bears-chj7/biocover/docs/dashboard.md

# 로컬 센서 웹 대시보드

Jetson 자체에서는 **http://127.0.0.1:8080**, 다른 기기에서는
**http://192.168.123.101:8080**으로 접속한다(2026-09-13 현재 LAN IP).
서버는 기본 0.0.0.0:8080에서 IPv4 접속을 받는다. 로그인은 없다. 외부 CDN 없이 로컬 CSS/JavaScript/Canvas를 사용한다.

## 통합 탭

8080 한 주소에서 **실시간 / 로그 재생**을 선택한다. 탭 전환만으로 측정이 중단되거나
재생 파일·위치·배속이 초기화되지 않는다. 별도 8081 서비스는 사용하지 않는다.
서비스 설치·시작·종료는 아래의 `biocover-web.service` 명령 하나로 관리한다.
[재생 기능 사용법](replay.md)

## 설치 및 실행

현재 환경에서 Flask 3.1.2 설치를 확인했다. 다른 환경의 의존성은
`web/requirements.txt`에 기록했다. 실행 중인 CH340 드라이버와 기존 UNO udev 규칙을 사용한다.

```bash
sudo python3 scripts/install_dashboard.py
```

설치기는 기존 `biocover-uno.service` 자동 CSV 수집을 중지/비활성화하고
`biocover-web.service`를 설치하되 중지/비활성화 상태로 둔다. 서비스는 judgejack 권한과 gpio 보조 그룹으로
실행한다. 부팅 및 서비스 오류 후 자동 실행하지 않으며 사용자가 직접 시작한다. **새 측정은 시작 버튼을 눌러야 한다. 재개 정보가 있는 진행 중 세션은 같은 CSV에 이어 쓴다.**
기존 웹 서비스 파일이 있으면 `/var/backups/biocover/UTC시각/`에 백업한다.
사용자가 관리자 비밀번호를 입력해야 하며 에이전트의 sudo -n 시도는 실패했다.
이 문서 작성 시점에서 시스템 설치/실제 센서 웹 수신 검증은 대기 상태다.

수동 실행은 기존 수집 서비스를 먼저 중지한 다음:

```bash
python3 web/app.py
```

기본 포트 8080, 데이터 폴더 data/web. `--port`와 `--data-dir`로 변경 가능하다.
동일 폴더로 두 서버를 실행하면 잠금으로 거부한다. 설치 서비스와 수동 서버를 동시에
실행하지 않는다. 앱은 가짜/예제 값을 센서값 대신 표시하지 않는다.

## 화면과 측정 동작

- 시작: 새 세션, 최신 UNO 캐시 + 그 시점의 ADC 읽기. 즉시 첫 행,
  이후 5초마다 갱신. 첫 UNO 응답 전에는 해당 항목을 결측으로 기록한다.
- 일시정지: CSV/로그/그래프 추가를 멈춘다. UNO 입력은 계속 받아 최신값을 유지한다.
- 재개: 같은 세션 파일에 최신값부터 이어 기록한다. 정지 구간을 소급해 채우지 않는다.
- 정지: 파일을 마무리하고 다운로드 목록에 표시한다. 다음 시작은 새 세션이다.
- 센서 8개 항목: DS18 온도, DHT22 온도/습도, MQ-4 #1~#4 raw, 토양수분 raw.
  ADC는 공칭 VREF 3.3V 전압도 표시한다. ppm/수분 % 보정은 하지 않는다.
- 미연결 CM1106은 별도 표시한다. MQ-4 #1은 유입, #2/#3/#4는 유출로 표시한다.
- 집계: 세션 전체의 유효값만으로 평균/최솟값/최댓값 계산. 결측은 제외한다.
- 그래프: 최근 5/10/30분, 1시간, 2시간, 전체 선택. 전체는 현재 측정 세션 시작부터 표시한다.
  최근 범위 선택 시 표시 범위 밖 값은 왼쪽으로 빠져나간다.
  결측과 일시정지 구간을 선으로 연결하지 않는다.
  토양 온도·공기 온도·습도·MQ-4 #1~#4·토양수분을 각각 분리하여
  한 행에 한 계열씩 총 8개 그래프로 표시한다. 모바일에서도 단일 열을 유지하고
  시간축 눈금 수를 줄여 겹침을 방지한다.
  표시 폭이 30분 이상이면 점을 숨기고 선만 표시하며, 미만이면 반지름 1.2px의 작은 점을 표시한다.
- 그래프 패널을 오른쪽으로 드래그하면 과거, 왼쪽으로 드래그하면 이후 구간을 본다.
  여덟 그래프의 시간축이 함께 이동한다. 과거 구간은 새 측정이 와도 고정하며
  **최신 구간** 버튼이나 오른쪽 끝까지 이동하면 다시 최신값을 따라간다.
  범위를 바꾸거나 새 세션을 시작해도 최신 구간으로 돌아간다.
  **← 이전 데이터 / 이후 데이터 →** 표시는 해당 측정값이 화면 밖에 남아 있는 방향에만 나타난다.
  전체 범위에서는 이미 모든 기록이 보여 이동하지 않는다. 측정·카드·통계·CSV는 그래프 이동의 영향을 받지 않는다.
  그래프에 키보드 포커스를 두고 좌우 방향키, Home/End로도 이동할 수 있다.
- 로그: 최신순 120행의 스크롤 영역. 서버 메모리는 최근 720행으로 제한하며
  화면에서 사라진 행도 CSV에는 남는다.
- 긴 범위에 필요한 과거 기록은 읽기 전용 `/api/history`로 현재 세션 CSV에서 가져온다.
  브라우저는 최근 값과 sequence로 합쳐 보관하므로 새로고침 후에도 시작 시점부터 조회할 수 있다.
  이 변경을 처음 반영할 때는 측정을 마친 후 웹서비스를 한 번 재시작해야 한다.
- 브라우저 새로고침은 서버 세션을 유지한다. 모든 브라우저는 같은 측정 세션을 본다.
  브라우저 연결이 끊기거나 모바일 화면이 잠겨도 측정을 계속한다.
  웹의 사용자 정지 시 세션을 마무리한다. 서비스 종료 시에는 다음 실행에서 이어 쓰도록 보존한다. 일시정지도 연결 여부와 무관하게 유지한다.

UNO는 약 2초 주기로 수신하고, 마지막 수신이 6초보다 오래되면 이전 값을 재사용하지 않는다.
USB 연결 오류나 ADC 오류는 해당 그룹의 결측으로 기록한다. 정상 형식의 숫자가
센서 교정 정확도를 보장하지는 않는다. 웹 화면은 2초마다 상태를 조회하지만
측정/CSV/로그의 새 행은 5초마다 하나다.

## CSV와 비정상 종료

진행 중: `data/web/session-YYYYMMDDTHHMMSS.ffffffZ.partial.csv`.
웹에서 정상 정지: 같은 타임스탬프의 `.csv`. `data/web/session-state.json`에는
진행 중 CSV와 시작 시각·행 수·측정 상태·교반 설정을 저장한다. 서비스 재시작 시
마지막 불완전 행을 제거하고 같은 `.partial.csv`에 이어 쓴다. 일시정지 상태는 유지한다.
자동 교반 판단용 최근값도 CSV에서 복원하며, 유효한 최근 기록이 충분하면 새 기준 수집을 기다리지 않는다.
교반 후 남은 재구동 대기 시간은 유지한다. 상세 조건은 [자동 교반 사용법](auto-mixer.md)을 참고한다.
재개 정보가 없는 과거 부분 파일만 `-recovered.csv`로 보존한다.
파일명/CSV 시각은 UTC이며 화면 시각은 브라우저 시간대다.

각 측정 행마다 flush + fsync하고, 파일 이름 변경 후 디렉터리도 fsync한다.
SIGTERM/일반 종료와 SIGKILL 모두 다음 실행에서 진행 중 세션을 복원하며
마지막 완료된 기록까지 유지한다. 전원 차단 중 진행하던 행과 저장장치 자체의
장애까지 보장할 수는 없다. 저장 오류 시 측정 상태를 오류로 전환한다.
파일 보존 기간/자동 삭제는 설정하지 않았으므로 디스크 사용량을 관리한다.

CSV 열: timestamp, sequence, elapsed_s, ds18, temperature, humidity,
mq1, mq2, soil, mq1_v, mq2_v, soil_v, uno_received_at, uno_time_ms,
uno_age_s, uno_status, adc_status, errors.
elapsed_s는 일시정지를 포함한 세션 경과 시간이다. UNO time_ms는 별도 기기의 uptime이다.
기존 data/arduino 파일은 보존하지만 대시보드 세션 목록은 data/web만 표시한다.

## 검증

```bash
python3 -m unittest discover -s tests -p test_dashboard.py -v
node --check web/static/app.js
```

자동 검증: 시작 전 미저장, 중복 시작 거부, 일시정지/재개/정지, CSV 행과 통계,
파일 다운로드, 다른 출처의 제어 요청 차단, 브라우저 단절 후 측정 유지, UNO 데이터 신선도,
실제 자식 프로세스 SIGKILL 후 CSV 복구. 센서값은 테스트에서만 합성 입력을 사용한다.

6개 unittest와 Python/JavaScript/systemd 문법 검증을 통과했다.
현재 로컬 Chromium의 Snap/GLIBC/ICU 실행 오류로 브라우저 화면 캡처는 완료하지 못했다.
설치 후 실제 화면과 실측 수신의 최종 확인이 필요하다.

## 서비스 관리

설치는 한 번만 수행한다. 이미 자동 실행으로 설치했으면 아래 명령을 한 번 실행한다.

```bash
sudo systemctl disable --now biocover-web.service
```

필요할 때 시작하고 브라우저에서 http://127.0.0.1:8080 을 연다.

```bash
sudo systemctl start biocover-web.service
```

사용을 마치면 화면의 정지 버튼으로 측정을 종료한 뒤 웹서버도 중지할 수 있다.
서비스 중지만 하면 다음 서비스 실행에서 진행 중 CSV에 이어 쓴다.

```bash
sudo systemctl stop biocover-web.service
```

```bash
systemctl status biocover-web.service --no-pager
journalctl -u biocover-web.service -n 30 --no-pager
sudo systemctl disable --now biocover-web.service
```

웹서버를 중지해도 기존 CSV를 삭제하지 않는다. 독립 센서 스크립트 실행 전
웹 측정 세션을 정지해서 USB 포트를 반환한다.
구현 참고: [Flask 공식 문서](https://flask.palletsprojects.com/en/stable/quickstart/).

## 다른 기기에서 IP로 접속

현재 Wi-Fi 주소는 `192.168.123.101/24`이며 DHCP에 따라 바뀔 수 있다.
주소 확인은 `ip -br address`. `0.0.0.0`은 서버가 듣는 주소이며 브라우저에 입력할 주소가 아니다.
로컬 접속만 원하면 수동 실행 시 `python3 web/app.py --host 127.0.0.1` 사용.
IP 주소 요청은 허용하고, 다른 웹사이트가 보내는 제어 요청은 계속 거부한다.
로그인이 없으므로 접속 가능한 기기는 같은 측정 세션을 제어하고 CSV를 내려받을 수 있다.

이전 실행 프로세스는 재시작해야 수정이 반영된다. 아래 명령은 서버 재시작 후
리스닝 주소, 자기 IP HTTP 응답, UFW 및 INPUT 규칙을 조회한다. 방화벽은 변경하지 않는다.
진행 중인 측정은 재시작 후 같은 CSV에 이어 쓴다. 중단 시간의 측정값은 채워 넣지 않는다.

```bash
sudo python3 scripts/check_web_network.py
```

자기 IP 요청 성공은 다른 기기에서의 접속 성공을 증명하지 않는다.
같은 네트워크의 기기에서 직접 접속해 확인한다. 공유기 밖 인터넷에서의 접속은
별도 라우팅/포트 전달이 필요하며 이 작업에서는 공유기 설정을 변경하지 않았다.
방화벽 조회는 에이전트의 sudo 비밀번호 요구로 아직 미완료다.

## MQ-4 네 개 수집과 이전 CSV

2026-10-09부터 CH0~CH3를 MQ-4 #1~#4로 읽고, CH4는 토양수분으로 유지한다.
5초마다 `mq1`~`mq4` raw와 `mq1_v`~`mq4_v` 전압을 함께 기록한다.
카드·평균/최솟값/최댓값·그래프·로그에 네 센서를 표시한다.

이전 2채널 CSV에는 `mq3`, `mq4`, `mq3_v`, `mq4_v`를 **0**으로 추가한다.
`mq34_backfilled=1`은 당시 측정하지 않은 값을 0으로 채웠다는 뜻이다.
새로운 측정 행은 `mq34_backfilled=0`이며, 통신 실패는 기존대로 빈 값으로 저장한다.
이전 기록의 0도 재생 통계에 포함되므로 새 센서 성능 분석 시 이 표시가 1인 행은 제외한다.

변환 스크립트는 완료된 `session-*.csv`만 처리하고 `.partial.csv`는 건너뛴다.
원본과 SHA-256 기록은 `data/backups/mq4-zero-fill-<UTC>/`에 보관한다.
기존 열의 값·시간·행 수·파일명·수정 시각을 보존하고, 새 파일로 원자적 교체하므로
파일시스템 생성 시각은 변환 시각이 될 수 있다. 이미 네 채널 열이 있으면 재변환하지 않는다.

```bash
cd /home/judgejack/working_space/biocover
python3 scripts/upgrade_mq4_csv.py          # 변경 대상 미리 보기
python3 scripts/upgrade_mq4_csv.py --apply  # 원본 백업 후 변환
sudo systemctl restart biocover-web.service
```

진행 중인 세션은 먼저 웹의 정지 버튼으로 정상 저장한다. 재시작 후 페이지를 새로고침하고
시작 버튼을 누르면 네 채널로 기록한다. [실제 전환 기록](../history/2026-10-09/four-mq4-dashboard.md)

## 모터 제어

실시간 탭의 모터 패널에서 USB 연결, 설정 각도 조회, 0~180도 전송을 지원한다.
측정을 시작하지 않고도 제어할 수 있다. [사용법과 저장 형식](motor-control.md)

자동 교반 패널은 유출 #2/#3/#4 각각의 기준 대비 변화율 차이 또는 공통 상승을 감지한다.
기본은 꺼짐이며 [자동 교반 사용법](auto-mixer.md)에 따라 측정 중 활성화한다.
