bears-chj7/biocover/history/README.md

# 실험·장치 작업 이력

현재 상태와 계획은 [프로젝트 README](../README.md), 날짜별 작업 경위와 증거는 이 디렉터리에서 관리합니다.
시간은 별도 표기 없으면 KST(UTC+09:00)입니다. 커널 부팅 로그의 시계 동기화 전 날짜는 실제 작업 시각으로 사용하지 않습니다.

| 날짜 | 이력 | 최종 확인 상태 |
|---|---|---|
| 2026-10-10 | [자동 교반 후속 확인](2026-10-09/auto-mixer.md#2026-10-10-사용자-확인) | 사용자가 확인 완료를 전달함 |
| 2026-10-09 | [MQ-4 점검](2026-10-09/mq4-four-channel-check.md) · [4채널 수집·CSV 전환](2026-10-09/four-mq4-dashboard.md) · [UNO 모터 제어](2026-10-09/arduino-motor.md) · [자동 교반](2026-10-09/auto-mixer.md) | 네 채널·유출 #3/#4·모터 응답 지원, CSV 총 4개 2,266행의 #3/#4 0 채움 |
| 2026-09-29 | [CSV 로그 재생 서버](2026-09-29/README.md) | 8081 별도 서비스 실행, 1~50배속·모바일 검증, 기존 8080 서비스 PID 유지 |
| 2026-09-14 | [브라우저 연결 만료 정지 수정](2026-09-14/README.md) | 117행 CSV 보존 확인, 45초 자동 정지 제거, 서비스 재시작 대기 |
| 2026-09-13 | [통합 타임라인](2026-09-13/README.md) · [USB 전환 이후](2026-09-13/usb-and-current-status.md) | UNO 온·습도와 ADC 3채널 수신 성공, 재부팅 후 CSV 재개 확인, 자동 저장 중지 적용 대기 |

## 기록 원칙

- 사용자 진술, 다른 세션 인계, 로컬 파일 확인, 실제 측정 결과를 구분합니다.
- 과거 ‘미설치’ 기록을 삭제해 성공으로 바꾸지 않고 이후 설치 증거를 연결합니다.
- ‘빌드 성공’, ‘설치 완료’, ‘드라이버 로드’, ‘센서 응답’, ‘보정 정확도’를 별도 상태로 기록합니다.
- 시스템 변경에는 대상 파일·백업·검증·미해결 사항을 남깁니다.
- 아카이브 파일은 당시 상태의 사본입니다. 이전 설치 스크립트·복원 안내를 현재 시스템에 그대로 실행하지 않습니다.
- 원시 측정값은 사용자가 명시적으로 요청할 때만 파일로 저장합니다. 이 디렉터리는 장치 구축 이력이며 원시 CSV는 Git에서 제외합니다.
