bears-chj7/biocover/history/2026-09-13/README.md

# 2026-09-13 통합 작업 이력

대상: 바이오커버 메탄 산화 측정 실험 / Jetson Orin Nano Super / L4T 36.4.7 / Linux 5.15.148-tegra.

## 세션 구분

**최신 상태:** [GPIO 반복 진단 → USB 전환 → 재부팅 검증 → 저장 정책 변경](usb-and-current-status.md).
아래 초기 타임라인과 문서의 미해결 표기는 당시 상태이며 최신 결과는 위 문서를 우선한다.

- **센서·저장소 세션:** SPI/ADC, DHT22, Git 저장소와 실험 개요를 관리한 현재 세션.
- **DS18B20 세션:** `/home/judgejack/project/ds18b20`에서 외부 모듈과 통합 오버레이를 준비한 다른 로컬 Codex 세션.
- **사용자:** 관리자 권한이 필요한 명령과 재부팅을 직접 수행.

다른 세션 인계의 ‘설치·로드 미검증’은 준비 작업 종료 시점의 상태입니다. 이후 사용자 설치·재부팅과 현재 세션의 확인 결과가 이를 갱신합니다. 두 기록은 모순이 아닙니다.

## 타임라인

정확한 명령 실행 시각이 남지 않은 단계는 대화 순서로만 표시합니다. 파일명·mtime는 보조 증거이며 모든 단계의 정확한 실행 시각을 보장하지 않습니다.

| 순서 / 확인 가능한 시각 | 담당 | 작업과 확인 |
|---|---|---|
| 초기 점검 | 센서 세션 | 인계문 ‘부팅 불가’와 달리 실제 OS 동작 확인. 샌드박스 제한을 구분한 후 SPI·UART·GPIO 장치 존재 확인 |
| 초기 연결 정정 | 사용자 | 최종 연결 상태: MQ-4 #1·#2, 토양수분, DHT22, DS18B20 연결. MQ-4 #3·#4, CM1106 미연결 |
| SPI 수정 전 | 센서 세션·사용자 | CH0~CH4 전부 0. Jetson-IO 조회에서 P19·21·23·24 unused |
| 16:51대 설정 파일 생성 / 재부팅 | 사용자 | Jetson-IO spi1 설정. 이후 활성 DT에서 SPI 기능 확인 |
| 16:55 전후 재검사 | 센서 세션 | CH0 181~186, CH1 115~121, CH4 820~834. DHT22 에지 0. CONFIG_W1 비활성 확인 |
| DHT22 핀 조회·수정 준비 | 사용자·센서 세션 | P15 tristate=1/input=1 확인. SPI를 보존하고 P15만 수정한 오버레이 컴파일·시험 병합 |
| DHT22 백업·설치 | 사용자 | 원본 before-dht22 백업. 후보와 설치본 SHA256 일치 확인. 다른 세션 작업 때문에 재부팅 보류 |
| 저장소 생성·정리 | 센서 세션 | GitHub 빈 저장소 clone, 실험 개요·배선·진단·설정 기록 작성 |
| 17:12:45 커밋 시각 | 센서 세션 | 초기 커밋 `4abdffd`. HTTPS 인증 실패 후 SSH 원격으로 전환해 main push 성공 |
| 다른 세션 준비 (파일 17:14~17:17대) | DS18B20 세션 | v5.15.148 W1 소스 외부 모듈 빌드, P7 통합 오버레이, 설치·읽기 스크립트·차이 검증 작성. 해당 세션은 sudo 암호 요구로 설치하지 않음 |
| 백업명 17:17:55 / 이후 재부팅 | 사용자 | 드라이버 설치·재부팅 완료 보고. 부팅 백업·설치본·현재 OVERLAYS로 후속 확인 |
| 17:23 이후 | 센서 세션 | SPI·P15 유지 확인. wire·w1_gpio 로드, w1_therm 파일 설치 확인. 정상 DS18B20 ID 없음 |
| 재부팅 후 ADC·DHT 검사 | 센서 세션 | CH0 168~173, CH1 109~114, CH4 804~809. DHT22 부분 펄스만 검출, 유효 프레임 없음 |
| 17:28:11 커밋 시각 | 센서 세션 | 재점검과 실험적 C 진단을 `82587f3`에 기록 |
| 17:35 전후 재점검 | 센서 세션 | CH0 207~214, CH1 149~155, CH4 803~809. DHT22 부분 펄스, DS18B20 정상 ID 없음; 설정 변경 없음 |
| 통합 history 작성 | 센서 세션 | 다른 세션 제공 인계·실제 파일·설치 증거·후속 실패를 날짜별 기록으로 통합 |

## 상세 문서

- [웹 대시보드 구현·검증 및 설치 대기](web-dashboard.md)

- [USB 전환과 재부팅 이후 최신 값·남은 작업](usb-and-current-status.md)
- [P7/P15 OS 감사와 TXB0108 원인 분석](gpio-os-audit.md)

- [센서·SPI·DHT22 작업](sensor-session.md)
- [DS18B20 빌드·설치·후속 검증](ds18b20-session.md)
- [현재 상태와 다음 작업](status-and-next.md)
- [증거 파일 설명](artifacts/README.md)
- [기존 상세 측정 로그](../../docs/2026-09-13-check.md)

## 주요 커밋

- `4abdffd`: 실험 개요와 센서 점검 및 Jetson 설정 기록 추가.
- `82587f3`: 드라이버 설치 후 센서 재점검과 DHT22 수신 한계 기록.
- 이 history를 추가한 커밋은 `git log -- history`에서 확인합니다.
