bears-chj7/biocover/history/2026-09-13/status-and-next.md

# 당일 최종 상태와 다음 작업

## 측정 가능 여부

| 대상 | 최종 상태 | 남은 일 |
|---|---|---|
| MQ-4 #1·#2 | ADC 값 읽힘 | 전압 범위·분압 확인, 예열·개별 보정, 농도·정확도 검증 |
| 토양수분 | CH4 값 읽힘 | 배지별 수분 보정·단위 정의 |
| DHT22 | P15 수정 적용, 부분 펄스 검출 | GPIO 읽기 타이밍/신호 검사, 완전 프레임·체크섬 확보 |
| DS18B20 | 외부 모듈 설치, 버스 생성 | 풀업 연결 보고 후 장치 0개. DATA 전압·배선·신호 검사, 28-… ID·CRC·온도 확보 |
| MQ-4 #3·#4 / CM1106 | 미연결 | 필요 시 추가 연결·배치·보정 |

## 다음 순서

1. P7 pinconf 조회는 완료됐습니다. 원문은 [증거 파일](artifacts/pin7-pinconf-user.txt)에 보관했습니다. 다음은 당시 사용한 조회 명령입니다.

```bash
sudo grep -i -A 14 'soc_gpio59_pac6' /sys/kernel/debug/pinctrl/2430000.pinmux/pinconf-groups
```

2. P7 설정 반영을 확인했으므로 DS18B20 전원·공통 GND·실제 4.7kΩ 풀업과 DATA 신호를 확인하며 드라이버 타이밍 가능성도 남겨 둡니다. 설정 변경은 기존 통합 SPI/P15/P7 내용을 보존합니다.
3. DHT22의 누락 없는 읽기 방식을 검증합니다. 현재 C 후보는 성공한 구현이 아닙니다.
4. 센서 검증 후 실험용 5초 CSV 수집, 보정, 유량·희석·실험 대조 설계를 구현합니다.

## 하지 않은 작업

이력 정리 과정에서 모듈 재설치·부팅 설정 변경·재부팅·가스 공급·파일시스템 복구는 하지 않았습니다. 센서가 정상 동작한다고 가정한 가짜 온도·농도 데이터도 생성하지 않았습니다.

## 동시 세션 작업

DS18B20 원래 준비 파일은 `/home/judgejack/project/ds18b20`에 유지합니다. 이력 사본은 원본 작업 디렉터리를 대체하지 않습니다. 같은 부팅 설정을 수정하는 경우 다른 세션의 최신 변경과 비교한 뒤 진행해야 합니다.

최신 사용자 보고: DS18 풀업 연결 완료, DHT22 실제 전원 P1 공유·3.4V 실측. DHT22 점검은 보류하고 DS18을 먼저 진행합니다. 18:33 전후 재검사에서 DS18은 장치 0개였습니다.
# 최신 상태 안내

이 문서의 초기 GPIO 진단 상태 이후 UNO USB 수신, 영구 설치 및 재부팅 후
수집 재개를 확인했다. [현재 상태와 저장 정책](usb-and-current-status.md)을 우선한다.
