bears-chj7/biocover/web/sensors.py

"""Live USB cache + on-demand ADC. No sensor data files are written here."""
import fcntl
import os
from pathlib import Path
import select
import subprocess
import sys
import termios
import threading
import time

sys.path.insert(0, str(Path(__file__).resolve().parents[1] / 'scripts'))
from read_arduino_usb import parse_line
from arduino_protocol import parse_event
from show_all_sensors import read_adc
from motor import Motor


class Sensors:
    def __init__(self, port='/dev/biocover-uno'):
        self.port = port
        self.lock = threading.Lock()
        self.stop_event = threading.Event()
        self.thread = None
        self.latest = None
        self.error = 'UNO 응답 대기'
        self.lifecycle = threading.Lock()
        self.motor = Motor()

    def start(self):
        with self.lifecycle:
            self._start()

    def _start(self):
        if self.thread and self.thread.is_alive():
            return
        result = subprocess.run(['systemctl', 'is-active', 'biocover-uno.service'],
                                capture_output=True, text=True, timeout=3)
        if result.stdout.strip() in ('active', 'activating'):
            raise RuntimeError('기존 CSV 수집 서비스가 실행 중입니다. 웹서버 설치 명령으로 전환해 주세요.')
        self.latest = None
        self.error = 'UNO 응답 대기'
        self.stop_event.clear()
        self.thread = threading.Thread(target=self._loop, daemon=True)
        self.thread.start()

    def _loop(self):
        while not self.stop_event.is_set():
            try:
                self._read_connection()
            except (OSError, ValueError) as exc:
                with self.lock:
                    self.error = f'UNO 연결 오류: {exc}'
                self.motor.offline(str(exc))
            self.stop_event.wait(2)

    def _read_connection(self):
        fd = os.open(self.port, os.O_RDWR | os.O_NOCTTY | os.O_NONBLOCK)
        old = None
        exclusive = False
        try:
            fcntl.flock(fd, fcntl.LOCK_EX | fcntl.LOCK_NB)
            fcntl.ioctl(fd, termios.TIOCEXCL)
            exclusive = True
            old = termios.tcgetattr(fd)
            attrs = termios.tcgetattr(fd)
            attrs[0] = attrs[1] = attrs[3] = 0
            attrs[2] = termios.CS8 | termios.CREAD | termios.CLOCAL
            attrs[4] = attrs[5] = termios.B9600
            attrs[6][termios.VMIN] = attrs[6][termios.VTIME] = 0
            termios.tcsetattr(fd, termios.TCSANOW, attrs)
            termios.tcflush(fd, termios.TCIFLUSH)
            self.motor.online()
            buffer = b''
            last = time.monotonic()
            while not self.stop_event.is_set():
                if time.monotonic() - last > 12:
                    raise OSError('12초 동안 새 데이터가 없습니다')
                payload = self.motor.outgoing()
                if payload:
                    # At most one command, never replayed after a reconnect.
                    deadline = time.monotonic() + 1
                    while payload:
                        if time.monotonic() >= deadline:
                            raise OSError('시리얼 명령 전송 시간 초과')
                        if not select.select([], [fd], [], .1)[1]:
                            continue
                        try:
                            sent = os.write(fd, payload)
                        except BlockingIOError:
                            continue
                        if not sent:
                            raise OSError('시리얼 명령 전송 실패')
                        payload = payload[sent:]
                if not select.select([fd], [], [], .25)[0]:
                    continue
                chunk = os.read(fd, 4096)
                if not chunk:
                    raise OSError('USB 연결 해제')
                buffer += chunk
                while b'\n' in buffer:
                    line, buffer = buffer.split(b'\n', 1)
                    if not line.strip():
                        continue
                    try:
                        text = line.decode('ascii').strip()
                        event = parse_event(text)
                        if event is not None:
                            self.motor.feed(event)
                            if event['kind'] == 'ready':
                                with self.lock:
                                    self.latest = None
                                    self.error = 'UNO 재시작 후 새 측정 대기'
                            continue
                        value = parse_line(text)
                    except (ValueError, UnicodeError):
                        continue
                    if value is not None:
                        self.motor.sensor_seen()
                        last = time.monotonic()
                        with self.lock:
                            self.latest = (value, last)
                            self.error = ''
                if len(buffer) > 4096:
                    buffer = b''
        finally:
            self.motor.offline()
            try:
                if old is not None:
                    termios.tcsetattr(fd, termios.TCSANOW, old)
            except OSError:
                pass
            try:
                if exclusive:
                    fcntl.ioctl(fd, termios.TIOCNXCL)
            except OSError:
                pass
            os.close(fd)

    def sample(self):
        with self.lock:
            cached, error = self.latest, self.error
        result = dict(ds18=None, temperature=None, humidity=None, mq1=None, mq2=None,
                      mq3=None, mq4=None, soil=None, mq1_v=None, mq2_v=None,
                      mq3_v=None, mq4_v=None, soil_v=None, mq34_backfilled=False,
                      uno_received_at=None, uno_time_ms=None, uno_age_s=None,
                      uno_status='waiting', adc_status='ok', errors=[])
        motor = self.motor.snapshot()
        result.update(motor_angle=motor['angle'], motor_reported_at=motor['reported_at'],
                      motor_status='disconnected' if not motor['connected'] else
                      'pending' if motor['pending'] else 'error' if motor['error'] else
                      'known' if motor['angle'] is not None else 'unset' if motor['reported_at'] else 'unknown')
        if cached:
            row, received = cached
            age = max(0, time.monotonic() - received)
            result.update(uno_received_at=row['received_at_utc'], uno_time_ms=row['time_ms'],
                          uno_age_s=round(age, 3))
            if age <= 6 and not error:
                result.update(ds18=row['DS18B20_C'], temperature=row['DHT22_C'], humidity=row['humidity_pct'],
                              uno_status='partial' if row['invalid_fields'] else 'ok')
                if row['invalid_fields']:
                    result['errors'].append('UNO 결측: ' + row['invalid_fields'])
            else:
                result['uno_status'] = 'stale'
                result['errors'].append(error or 'UNO 데이터가 6초 이상 오래됨')
        else:
            result['errors'].append(error or 'UNO 응답 대기')
        try:
            adc = read_adc()
            for key, name in [('mq1','MQ4_1'), ('mq2','MQ4_2'), ('mq3','MQ4_3'),
                              ('mq4','MQ4_4'), ('soil','soil_moisture')]:
                result[key] = adc[name]['raw']
                result[key + '_v'] = adc[name]['voltage_V_nominal']
        except (OSError, ValueError) as exc:
            result['adc_status'] = 'error'
            result['errors'].append(f'ADC 읽기 실패: {exc}')
        return result

    def close(self):
        with self.lifecycle:
            self._close()

    def _close(self):
        self.stop_event.set()
        if self.thread:
            self.thread.join(timeout=3)
            if self.thread.is_alive():
                raise RuntimeError('UNO 읽기 스레드 종료 대기 시간 초과')
            self.thread = None
        self.motor.offline()
