bears-chj7/biocover/web/app.py

#!/usr/bin/env python3
"""IP-accessible sensor dashboard. No recording until a browser presses Start."""
import argparse
import fcntl
import ipaddress
from pathlib import Path
import signal
import sys
from urllib.parse import urlparse

from flask import Flask, jsonify, render_template, request, send_file
from werkzeug.serving import make_server
from werkzeug.middleware.dispatcher import DispatcherMiddleware
from engine import Engine
from sensors import Sensors

ROOT = Path(__file__).resolve().parents[1]
if str(ROOT) not in sys.path:
    sys.path.insert(0, str(ROOT))
from replay.app import create_app as create_replay_app


def create_app(engine):
    app = Flask(__name__)
    app.config['MAX_CONTENT_LENGTH'] = 1024

    @app.before_request
    def check_request():
        hostname = urlparse(request.host_url).hostname
        if hostname != 'localhost':
            try:
                ipaddress.ip_address(hostname)
            except ValueError:
                return jsonify(error='Jetson의 IP 주소로 접속해 주세요.'), 403
        if request.method == 'POST':
            if not request.is_json:
                return jsonify(error='JSON 요청이 필요합니다.'), 415
            origin = request.headers.get('Origin')
            if origin and urlparse(origin).netloc != request.host:
                return jsonify(error='다른 사이트의 제어 요청은 허용하지 않습니다.'), 403

    @app.after_request
    def headers(response):
        response.headers['Cache-Control'] = 'no-store'
        response.headers['X-Content-Type-Options'] = 'nosniff'
        return response

    @app.get('/')
    def index():
        return render_template('shell.html')

    @app.get('/live')
    def live():
        return render_template('index.html')

    @app.get('/api/state')
    def state():
        return jsonify(engine.snapshot())

    def motor_controller():
        motor = getattr(engine.source, 'motor', None)
        if motor is None:
            raise RuntimeError('이 센서 소스는 모터 제어를 지원하지 않습니다.')
        return motor

    @app.get('/api/motor')
    def motor_state():
        try:
            return jsonify(motor_controller().snapshot())
        except RuntimeError as exc:
            return jsonify(error=str(exc)), 409

    @app.post('/api/motor/connect')
    def motor_connect():
        try:
            motor = motor_controller()
            engine.source.start()  # Opens USB only; does not start CSV recording.
            return jsonify(motor.snapshot())
        except (RuntimeError, OSError) as exc:
            return jsonify(error=str(exc)), 409

    @app.post('/api/motor/status')
    def motor_query():
        try:
            return jsonify(motor_controller().request())
        except (RuntimeError, OSError) as exc:
            return jsonify(error=str(exc)), 409

    @app.post('/api/motor')
    def motor_command():
        body = request.get_json(silent=True)
        if not isinstance(body, dict) or type(body.get('angle')) is not int or not 0 <= body['angle'] <= 180:
            return jsonify(error='angle은 0~180 사이의 정수여야 합니다.'), 400
        try:
            engine.mixer_resume_pending = False
            engine.mixer.disable('수동 각도 명령으로 자동 교반을 중단했습니다.')
            engine.checkpoint()
            return jsonify(motor_controller().request(body['angle']))
        except (ValueError, RuntimeError, OSError) as exc:
            return jsonify(error=str(exc)), 409

    @app.get('/api/mixer')
    def mixer_state():
        return jsonify(engine.mixer.snapshot())

    @app.post('/api/mixer/<action>')
    def mixer_control(action):
        body = request.get_json(silent=True)
        if not isinstance(body, dict):
            return jsonify(error='JSON 객체가 필요합니다.'), 400
        try:
            # Serialize enabling against measurement pause/stop.
            with engine.lock:
                if action == 'enable':
                    if engine.state != 'running':
                        raise ValueError('센서 측정을 시작한 뒤 자동 교반을 켜세요.')
                    result = engine.mixer.enable(history=engine.rows)
                    engine.mixer_resume_pending = False
                elif action == 'disable':
                    engine.mixer_resume_pending = False
                    engine.mixer.disable()
                    result = engine.mixer.snapshot()
                elif action == 'settings':
                    result = engine.mixer.configure(body)
                else:
                    return jsonify(error='알 수 없는 자동 교반 동작'), 404
                engine.checkpoint()
            return jsonify(result)
        except (ValueError, RuntimeError) as exc:
            return jsonify(error=str(exc)), 409

    @app.get('/api/history')
    def history():
        try:
            after = int(request.args.get('after', '0'))
            limit = int(request.args.get('limit', '5000'))
            if after < 0 or not 1 <= limit <= 10000:
                raise ValueError()
        except ValueError:
            return jsonify(error='after는 0 이상, limit는 1~10000 정수여야 합니다.'), 400
        try:
            return jsonify(engine.history(after, limit))
        except OSError:
            return jsonify(error='세션 CSV를 읽을 수 없습니다.'), 503

    @app.post('/api/<action>')
    def control(action):
        if action not in ('start', 'pause', 'resume', 'stop', 'heartbeat'):
            return jsonify(error='알 수 없는 동작'), 404
        try:
            getattr(engine, action)()
            return jsonify(engine.snapshot())
        except (ValueError, RuntimeError, OSError) as exc:
            return jsonify(error=str(exc)), 409

    @app.get('/api/files')
    def files():
        return jsonify(engine.files())

    @app.get('/download/<name>')
    def download(name):
        if Path(name).name != name or name not in {v['name'] for v in engine.files()}:
            return jsonify(error='저장된 CSV를 찾을 수 없습니다.'), 404
        return send_file(engine.directory / name, as_attachment=True, download_name=name)

    # Keep upload limits, request guards and APIs separate while sharing one
    # HTTP listener. Replay never receives the engine or sensor object.
    replay = create_replay_app(engine.directory, integrated=True)
    app.wsgi_app = DispatcherMiddleware(app.wsgi_app, {'/replay': replay})
    return app


def main():
    parser = argparse.ArgumentParser(description=__doc__)
    parser.add_argument('--port', type=int, default=8080)
    parser.add_argument('--host', default='0.0.0.0', help='IPv4 listen address; default all interfaces')
    parser.add_argument('--data-dir', type=Path, default=Path(__file__).resolve().parents[1] / 'data/web')
    args = parser.parse_args()
    args.data_dir.mkdir(parents=True, exist_ok=True)
    lock = (args.data_dir / '.dashboard.lock').open('a')
    try:
        fcntl.flock(lock, fcntl.LOCK_EX | fcntl.LOCK_NB)
    except BlockingIOError:
        raise SystemExit('이미 이 데이터 폴더의 대시보드가 실행 중입니다.')
    engine = Engine(Sensors(), args.data_dir)
    server = make_server(args.host, args.port, create_app(engine), threaded=True)
    def terminate(signum, frame):
        raise KeyboardInterrupt
    signal.signal(signal.SIGTERM, terminate)
    print(f'Biocover listening: {args.host}:{args.port} (접속: http://<Jetson-IP>:{args.port}; 측정 상태: {engine.state})', flush=True)
    try:
        server.serve_forever()
    except KeyboardInterrupt:
        pass
    finally:
        engine.close()
        server.server_close()
        lock.close()


if __name__ == '__main__':
    main()
