bears-chj7/biocover/tests/test_dashboard.py

import csv
import io
import os
from pathlib import Path
import subprocess
import sys
import tempfile
import time
import unittest

ROOT = Path(__file__).resolve().parents[1]
sys.path.insert(0, str(ROOT / 'web'))
from engine import Engine
from app import create_app
from sensors import Sensors


class Fake:
    def start(self): pass
    def close(self): pass
    def sample(self):
        return dict(ds18=27.1, temperature=27.5, humidity=57., mq1=201, mq2=103,
                    mq3=714, mq4=527, soil=824, mq1_v=.648, mq2_v=.332,
                    mq3_v=2.303, mq4_v=1.7, soil_v=2.658,
                    motor_angle=30, motor_reported_at='2026-10-09T14:00:00+00:00', motor_status='known',
                    uno_status='ok', adc_status='ok', errors=[])


class DashboardTests(unittest.TestCase):
    def setUp(self):
        self.tmp = tempfile.TemporaryDirectory()
        self.engine = Engine(Fake(), self.tmp.name, interval=100)
        self.client = create_app(self.engine).test_client()
    def tearDown(self):
        self.engine.close()
        self.tmp.cleanup()
    def post(self, action):
        return self.client.post('/api/'+action, json={})
    def test_lifecycle_and_file(self):
        self.assertEqual(list(Path(self.tmp.name).glob('*.csv')), [])
        self.assertEqual(self.post('start').status_code, 200)
        self.assertEqual(self.post('start').status_code, 409)
        self.engine.tick()
        self.post('pause')
        before = self.engine.count
        self.engine.tick()
        self.assertEqual(self.engine.count, before)
        self.post('resume')
        self.engine.tick()
        self.post('stop')
        snapshot = self.engine.snapshot()
        path = Path(self.tmp.name) / snapshot['last_file']
        with path.open() as f:
            rows = list(csv.DictReader(f))
        self.assertEqual(len(rows), snapshot['count'])
        self.assertEqual(snapshot['stats']['mq1']['mean'], 201)
        self.assertEqual(snapshot['stats']['mq3']['mean'], 714)
        self.assertEqual(snapshot['stats']['mq4']['max'], 527)
        self.assertTrue(all(row['mq3'] == '714' and row['mq4'] == '527' for row in rows))
        self.assertTrue(all(row['mq34_backfilled'] == '0' for row in rows))
        replay = self.client.get('/replay/api/recording/' + path.name).json
        self.assertEqual(replay['rows'][-1]['mq3_v'], 2.303)
        self.assertEqual(replay['mq34_backfilled_count'], 0)
        self.assertEqual(replay['rows'][-1]['motor_angle'], 30)
        self.assertEqual(rows[-1]['motor_status'], 'known')
        with self.client.get('/download/'+path.name) as response:
            self.assertEqual(response.status_code, 200)
        self.assertEqual(self.client.get('/download/no.csv').status_code, 404)
        self.assertEqual(self.post('pause').status_code, 409)
    def test_origin_guard(self):
        self.assertEqual(self.client.post('/api/start').status_code, 415)
        self.assertEqual(self.client.post('/api/start', json={}, headers={'Origin':'https://bad.example'}).status_code, 403)

    def test_motor_api_validates_before_writing_and_replay_has_no_controls(self):
        from unittest.mock import Mock
        self.engine.source.motor = Mock()
        self.engine.source.motor.snapshot.return_value = dict(connected=True, angle=None)
        self.engine.source.motor.request.return_value = dict(connected=True, angle=30)
        for angle in (-1, 181, 30.5, True, '30', None):
            self.assertEqual(self.client.post('/api/motor', json={'angle': angle}).status_code, 400)
        self.engine.source.motor.request.assert_not_called()
        self.assertEqual(self.client.post('/api/motor', json={'angle': 30}).json['angle'], 30)
        self.engine.source.motor.request.assert_called_once_with(30)
        self.assertEqual(self.client.post('/api/motor', json={'angle': 30}, headers={'Origin': 'http://other.example'}).status_code, 403)
        self.assertEqual(self.client.post('/replay/api/motor', json={'angle': 30}).status_code, 404)
        self.assertEqual(self.client.post('/api/motor/connect', json={}).status_code, 200)
        self.assertEqual(self.engine.state, 'idle')
        self.assertEqual(list(Path(self.tmp.name).glob('*.csv')), [])

    def test_close_releases_manual_serial_connection_even_without_measurement(self):
        from unittest.mock import Mock
        self.engine.source.close = Mock()
        self.engine.close()
        self.engine.source.close.assert_called_once()

    def test_history_reads_older_csv_rows_without_changing_session(self):
        from unittest.mock import patch
        self.post('start')
        with patch('engine.os.fsync'):
            for _ in range(1500):
                self.engine.tick()
        self.engine.pause()
        count = self.engine.count
        self.assertEqual(len(self.engine.snapshot()['rows']), 720)
        first = self.client.get('/api/history?limit=1000').json
        second = self.client.get('/api/history?after=1000').json
        self.assertEqual(len(first['rows']), 1000)
        self.assertEqual(first['rows'][0]['sequence'], 1)
        self.assertEqual(first['rows'][0]['mq3'], 714)
        self.assertEqual(first['rows'][0]['mq4'], 527)
        self.assertEqual(len(first['rows']) + len(second['rows']), count)
        self.assertEqual(second['through'], count)
        self.assertEqual(self.engine.state, 'paused')
        self.assertEqual(self.engine.count, count)
        self.post('stop')
        self.assertEqual(self.client.get('/api/history').json['through'], count)
        self.assertEqual(self.client.get('/api/history?limit=0').status_code, 400)
        self.assertEqual(self.client.get('/api/history?after=-1').status_code, 400)
    def test_ip_access(self):
        base='http://192.168.123.101:8080'
        self.assertEqual(self.client.get('/api/state', base_url=base).status_code, 200)
        self.assertEqual(self.client.post('/api/heartbeat', base_url=base, json={},
                                         headers={'Origin':base}).status_code, 200)
        self.assertEqual(self.client.post('/api/heartbeat', base_url=base, json={},
                                         headers={'Origin':'http://other.example'}).status_code, 403)
        self.assertEqual(self.client.get('/api/state', base_url='http://other.example').status_code, 403)

    def test_single_port_shell_and_replay_do_not_control_live_measurement(self):
        shell = self.client.get('/').text
        self.assertIn('id="tab-live"', shell)
        self.assertIn('id="tab-replay"', shell)
        self.assertIn('/live?embedded=1', shell)
        self.assertIn('/replay/?embedded=1', shell)
        self.assertNotIn(':8081', shell)
        self.assertIn('id="start"', self.client.get('/live').text)
        replay = self.client.get('/replay/')
        self.assertEqual(replay.status_code, 200)
        self.assertIn('/replay/static/app.mjs', replay.text)
        self.assertIn("frame-ancestors 'self'", replay.headers['Content-Security-Policy'])
        self.post('start')
        self.engine.tick()
        self.engine.pause()
        count = self.engine.count
        partial = self.engine.path.read_bytes()
        # Replay cannot select or modify the active partial CSV.
        self.assertEqual(self.client.get('/replay/api/files').json, [])
        self.assertEqual(self.client.get('/replay/api/recording/'+self.engine.path.name).status_code,404)
        self.assertEqual(self.client.post('/replay/api/stop',json={}).status_code,404)
        payload = b'timestamp,ds18,temperature,humidity,mq1,mq2,soil\n' + b'2026-09-29T00:00:00Z,27,28,55,200,100,800\n'*100
        # Multipart upload > 1 KiB must bypass the live JSON/control size limit.
        response = self.client.post('/replay/api/upload', data={'file':(io.BytesIO(payload),'uploaded.csv')},
                                    headers={'Origin':'http://localhost'})
        self.assertEqual(response.status_code,200)
        self.assertEqual(response.json['count'],100)
        self.assertEqual(self.engine.count,count)
        self.assertEqual(self.engine.state,'paused')
        self.assertEqual(self.engine.path.read_bytes(),partial)
        self.assertEqual(self.client.post('/api/pause', data={'file':(io.BytesIO(payload),'uploaded.csv')}).status_code,415)
        self.assertEqual(self.client.post('/replay/api/upload',data={},headers={'Origin':'https://other.example'}).status_code,403)
        self.post('stop')
        self.assertEqual(len(self.client.get('/replay/api/files').json),1)
        with self.client.get('/replay/static/player.mjs') as asset:
            self.assertEqual(asset.status_code,200)
            self.assertIn('javascript',asset.content_type)
    def test_cadence_pause_and_finite_aggregation(self):
        self.engine.interval = .08
        self.engine.start()
        time.sleep(.55)
        self.engine.pause()
        count = self.engine.count
        self.assertGreaterEqual(count, 2)
        time.sleep(.3)
        self.assertEqual(count, self.engine.count)
        self.engine.source.sample = lambda: dict(ds18=float('nan'), temperature=29, errors=[])
        self.engine.resume()
        self.engine.tick()
        self.engine.pause()
        self.assertIsNone(self.engine.rows[-1]['ds18'])
        self.assertEqual(self.engine.stats['ds18']['count'], count)
    def test_disconnected_client_keeps_recording(self):
        self.engine.interval = .1
        self.engine.start()
        # Simulate a heartbeat older than the former 45-second deadline.
        self.engine.heartbeat_at = time.monotonic() - 60
        time.sleep(.5)
        self.assertEqual(self.engine.state, 'running')
        self.assertGreaterEqual(self.engine.count, 2)
        self.assertIsNone(self.engine.last_file)
        self.engine.pause()
        count = self.engine.count
        time.sleep(.3)
        self.assertEqual(self.engine.state, 'paused')
        self.assertEqual(self.engine.count, count)
        self.engine.stop()
        self.assertTrue(self.engine.last_file)
    def test_stale_usb_not_reused(self):
        from unittest.mock import patch
        s=Sensors();s.error='';s.latest=({'received_at_utc':'now','time_ms':1,
            'DS18B20_C':27,'DHT22_C':28,'humidity_pct':55,'invalid_fields':''}, time.monotonic()-7)
        with patch('sensors.read_adc', side_effect=OSError('test disconnect')):
            row=s.sample()
        self.assertIsNone(row['ds18'])
        self.assertEqual(row['uno_status'], 'stale')
        self.assertEqual(row['adc_status'], 'error')
        self.assertIsNone(row['mq3'])
        self.assertIsNone(row['mq4'])

    def test_adc_four_channel_mapping(self):
        from unittest.mock import patch
        values = [('MQ4_1', 201), ('MQ4_2', 103), ('MQ4_3', 714), ('MQ4_4', 527), ('soil_moisture', 824)]
        adc = {key: {'raw': raw, 'voltage_V_nominal': raw * 3.3 / 1023} for key, raw in values}
        with patch('sensors.read_adc', return_value=adc):
            row = Sensors().sample()
        for key, (_, raw) in zip(('mq1', 'mq2', 'mq3', 'mq4', 'soil'), values):
            self.assertEqual(row[key], raw)
            self.assertAlmostEqual(row[key + '_v'], raw * 3.3 / 1023)
        self.assertEqual(row['adc_status'], 'ok')
        self.assertFalse(row['mq34_backfilled'])
    def test_killed_process_recovery(self):
        code='''import sys,time
sys.path.insert(0,sys.argv[1])
from engine import Engine
class Fake:
 def start(self): pass
 def close(self): pass
 def sample(self): return dict(ds18=27,errors=[])
e=Engine(Fake(),sys.argv[2],interval=.05)
e.start()
time.sleep(30)
'''
        with tempfile.TemporaryDirectory() as other:
            p=subprocess.Popen([sys.executable,'-c',code,str(ROOT/'web'),other])
            try:
                deadline=time.monotonic()+4
                while time.monotonic()<deadline:
                    files=list(Path(other).glob('*.partial.csv'))
                    if files and len(files[0].read_text().splitlines())>=3: break
                    time.sleep(.05)
                else: self.fail('no persisted rows')
                p.kill();p.wait()
                with files[0].open('ab') as f: f.write(b'truncated-row')
                recovered=Engine(Fake(),other)
                try:
                    self.assertEqual(recovered.recovered,[])
                    self.assertEqual(recovered.path.name,files[0].name)
                    text=recovered.path.read_text()
                    self.assertNotIn('truncated-row',text)
                    self.assertGreaterEqual(len(text.splitlines()),3)
                    self.assertEqual(recovered.state,'running')
                finally: recovered.close()
            finally:
                if p.poll() is None: p.kill();p.wait()


if __name__=='__main__': unittest.main()
