bears-chj7/biocover/(commit log)

2026-09-13 실험 개요와 센서 점검 및 Jetson 설정 기록 추가
2026-09-13 드라이버 설치 후 센서 재점검과 DHT22 수신 한계 기록
2026-09-13 날짜별 history에 두 세션 작업과 DS18B20 설치 증거 통합
2026-09-13 17시35분 센서 반복 점검 결과 기록
2026-09-13 DHT22 GPIO 이벤트 수신 지연 진단과 미해결 결과 기록
2026-09-13 DS18 풀업 미연결 확인과 Arduino DHT 구현 비교 기록
2026-09-13 DHT22 실시간 우선순위 시험 실패와 5V Arduino 조건 기록
2026-09-13 DHT22 3핀 모듈 참조 이미지와 핀 표시 기록
2026-09-13 P15 GPIO 전환 지연 분리용 MMIO 진단 준비
2026-09-13 DHT22 MMIO 진단에서 비활성 에지 설정 허용
2026-09-13 DHT22 초기 LOW에 대한 입력 안정화 검사 추가
2026-09-13 DHT22 입력 안정화 후 지속 LOW 관측 기록
2026-09-13 DS18 풀업 연결 후 재점검과 DHT22 전원 실측 기록
2026-09-13 DS18 전압 재확인과 복구 가능한 RESET 응답 진단 준비
    [check_ds18_presence.py, ds18_presence.c]
2026-09-13 DS18 RESET 3회 무응답 및 드라이버 복구 결과 기록
2026-09-13 Explain P7 low voltage from TXB0108 pull-up conflict and correct wiring guidance
    [check_p7_voltage.py]
2026-09-13 Add UNO USB sensor reader and document CH340 driver preparation
2026-09-13 Record successful UNO USB sensor readings and brltty conflict resolution
2026-09-13 Document sensor troubleshooting, reboot results and explicit-only recording policy
    [install_arduino_usb.py, show_all_sensors.py]
2026-09-13 Add hardware wiring diagrams, board pin maps and verified reference guide
2026-09-13 Add local sensor dashboard with live charts and recoverable CSV sessions
2026-09-13 Split sensor charts into single-series rows and improve mobile spacing
2026-09-13 Keep sensor sessions running when browser heartbeats stop
2026-09-29 Add full-session chart ranges and replay seeking; record timestamp correction
    [app.py, engine.py, shift_session_time.py, test_dashboard.py, test_shift_session_time.py]
2026-10-09 Collect four MQ-4 sensors and backfill legacy recordings
2026-10-09 Support UNO servo commands and label three methane outlets
